KilowattSynthesis/Braille-Display-Column-Rods/README.md

# Braille-Display-Column-Rods
Braille display POC using tiny stepper motors to drive columns of the display

**Type 4 Braille Display**

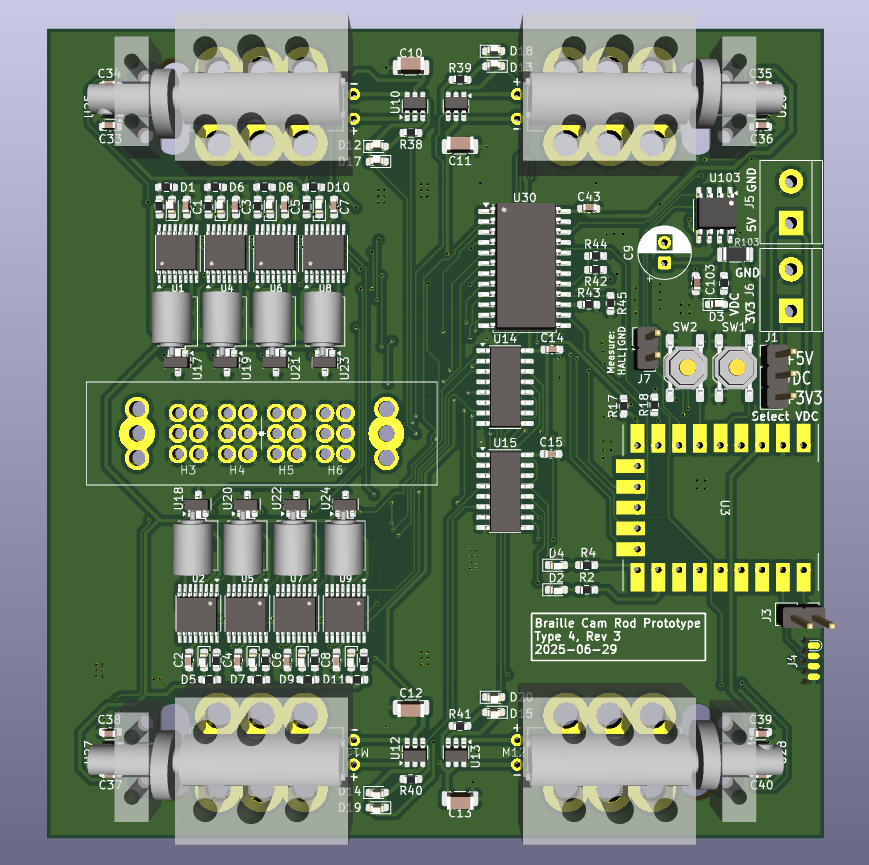
[picture p1: docs/renders/type-4-latest-top.png]
Type 4 Braille Display - Top Render
