KilowattSynthesis/Braille-Display-Column-Rods/docs/renders/type-4-rev-2-top.png

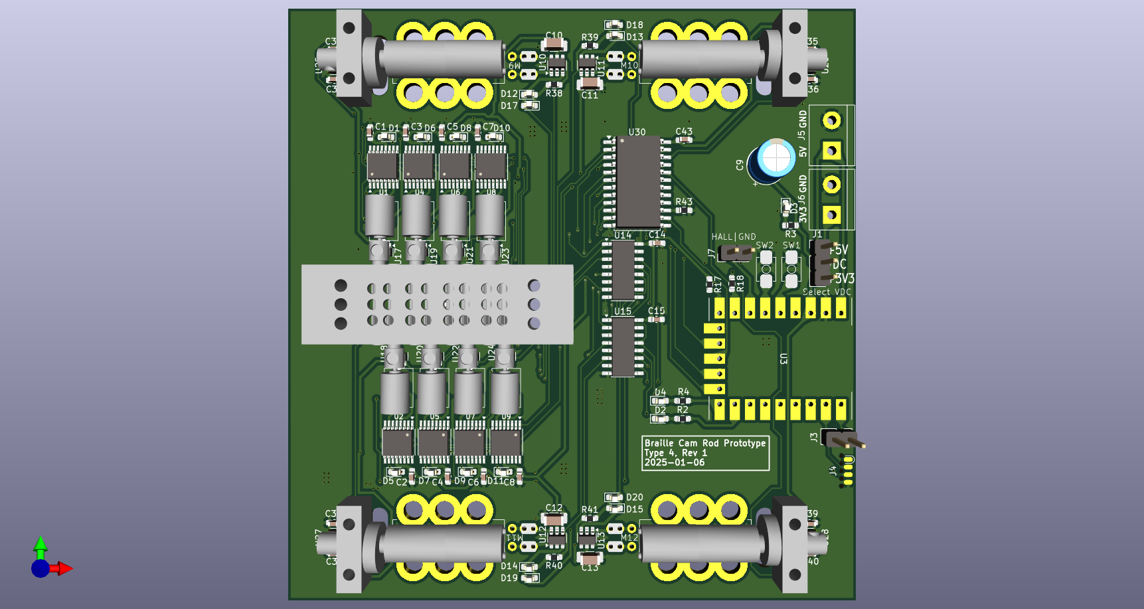
docs/renders/type-4-rev-2-top.png
