KilowattSynthesis/Braille-Display-Column-Rods/Braille-Column-Rods-PCB/lib-cad/octagon_cam_housing_assembly_preview_3p2_coupler.step

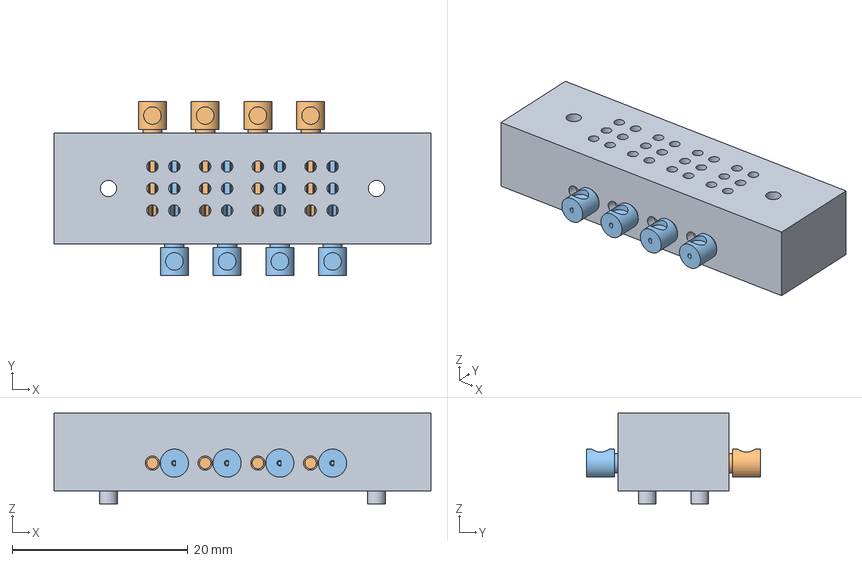
[picture p3: CAD file, 2025-03-13]
Braille-Column-Rods-PCB/lib-cad/octagon_cam_housing_assembly_preview_3p2_coupler.step
42.9 x 19.8 x 10.3 mm
