KilowattSynthesis/Braille-Display-Column-Rods/Braille-Column-Rods-PCB/lib-cad/assembly_cam_and_dc_motor.step

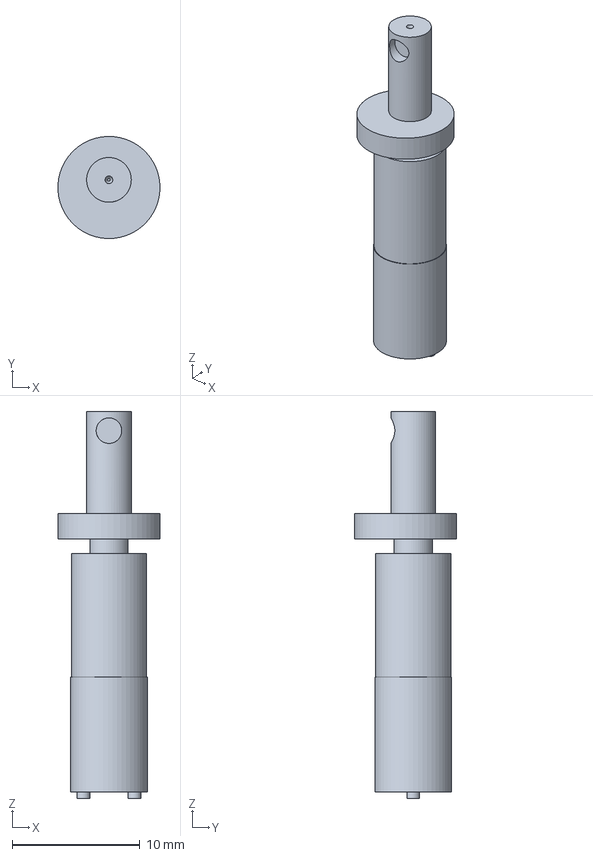
[picture p5: CAD file, 2025-02-03]
Braille-Column-Rods-PCB/lib-cad/assembly_cam_and_dc_motor.step
7.99 x 8.00 x 30.3 mm
