KilowattSynthesis/Braille-Display-Column-Rods/Braille-Column-Rods-PCB/lib-cad/bushing_block.step

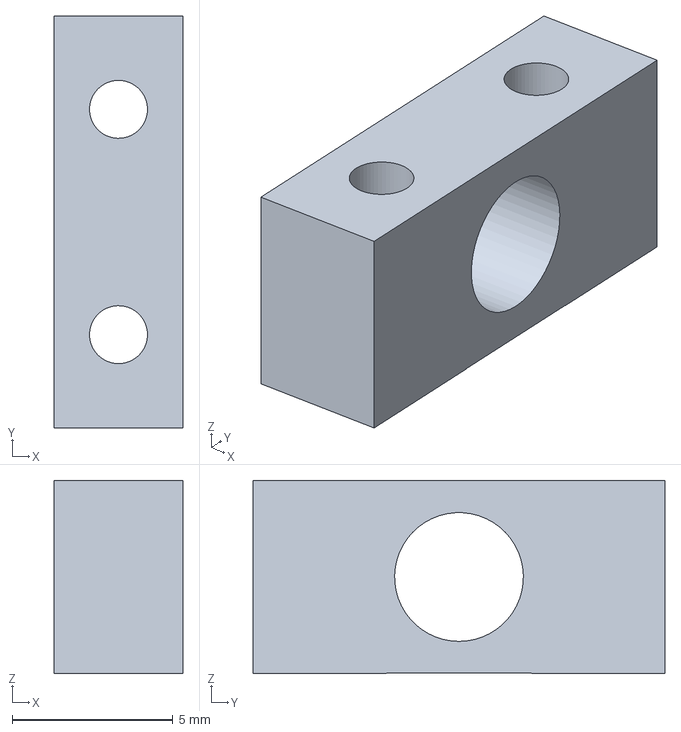
[picture p6: CAD file, 2025-03-13]
Braille-Column-Rods-PCB/lib-cad/bushing_block.step
4.00 x 12.8 x 6.00 mm
