KilowattSynthesis/Braille-Display-Column-Rods/Braille-Column-Rods-PCB/lib-cad/dc_motor_clamp.step

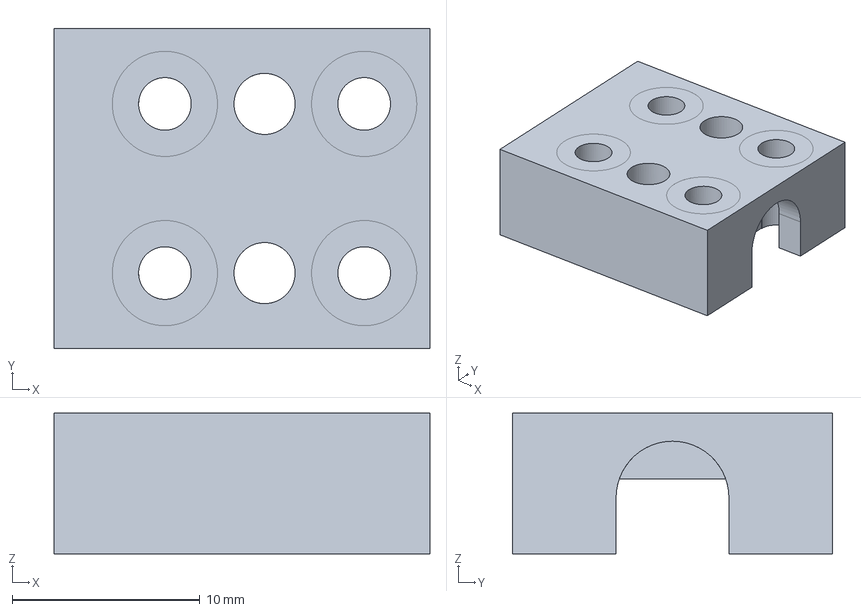
[picture p7: CAD file, 2025-03-13]
Braille-Column-Rods-PCB/lib-cad/dc_motor_clamp.step
20.0 x 17.0 x 7.50 mm
