KilowattSynthesis/Braille-Display-Column-Rods/Braille-Column-Rods-PCB/lib-cad/micro_stepper_motor_od_4p7.step

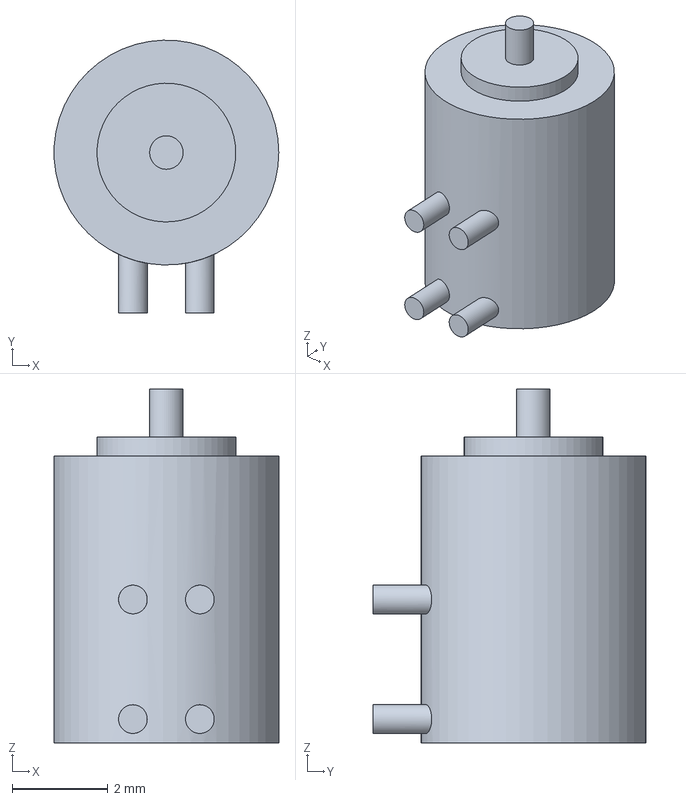
[picture p8: CAD file, 2025-02-03]
Braille-Column-Rods-PCB/lib-cad/micro_stepper_motor_od_4p7.step
4.70 x 5.70 x 7.40 mm
