KilowattSynthesis/Braille-Display-Column-Rods/Braille-Column-Rods-PCB/lib-cad/dc_motor_and_gearbox_6mm_3_stages.step

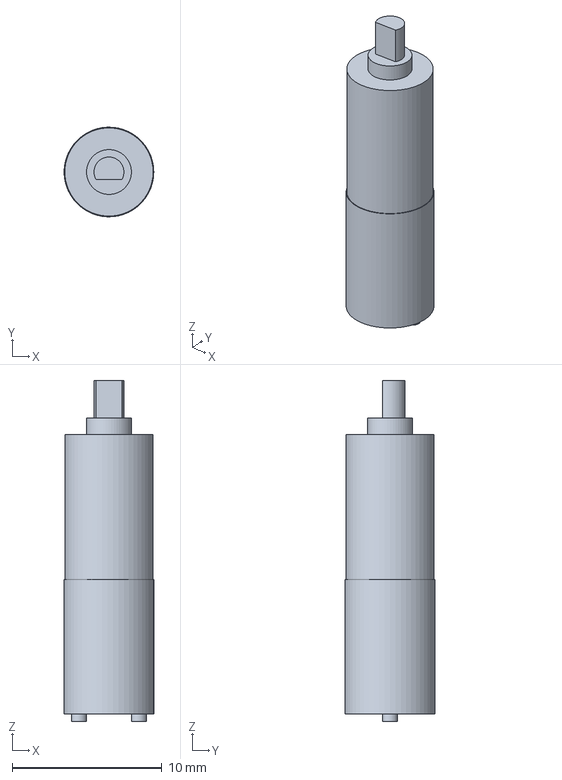
[picture p9: CAD file, 2025-02-03]
Braille-Column-Rods-PCB/lib-cad/dc_motor_and_gearbox_6mm_3_stages.step
5.99 x 6.00 x 22.8 mm
