KilowattSynthesis/Braille-Display-Column-Rods/Braille-Column-Rods-PCB/lib-cad/octagon_cam_housing_print_in_place.step

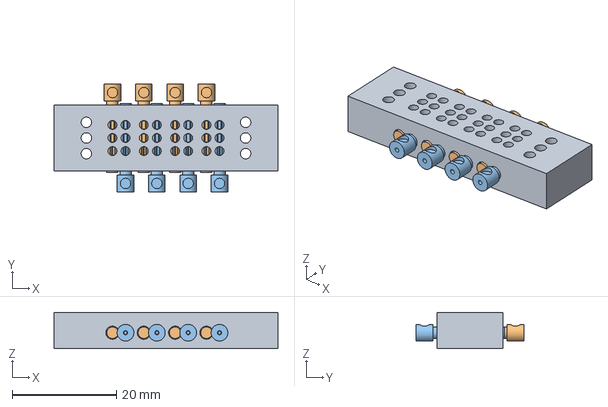
[picture p10: CAD file, 2025-02-03]
Braille-Column-Rods-PCB/lib-cad/octagon_cam_housing_print_in_place.step
42.9 x 20.6 x 6.95 mm
