KilowattSynthesis/Braille-Display-Column-Rods/Braille-Column-Rods-PCB/lib-cad/cam.step

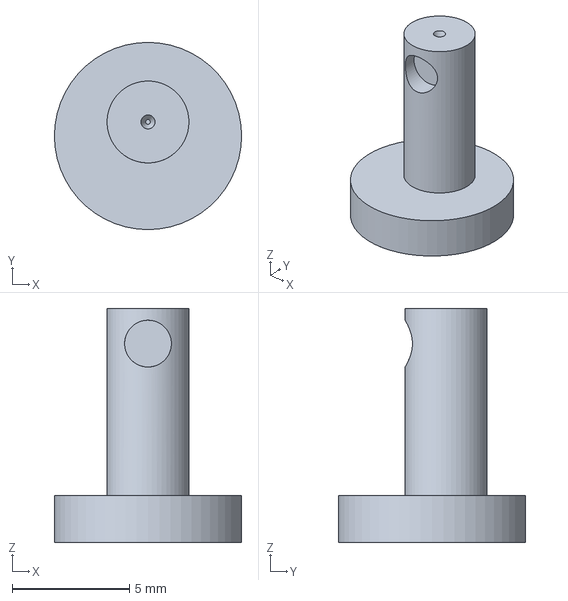
[picture p11: CAD file, 2025-02-03]
Braille-Column-Rods-PCB/lib-cad/cam.step
8.00 x 8.00 x 10.0 mm
