KilowattSynthesis/Braille-Display-Column-Rods/Braille-Column-Rods-PCB/Braille-Column-Rods-PCB.kicad_pcb

## KiCad design Braille-Column-Rods-PCB/Braille-Column-Rods-PCB.kicad_pcb (2025-06-30)

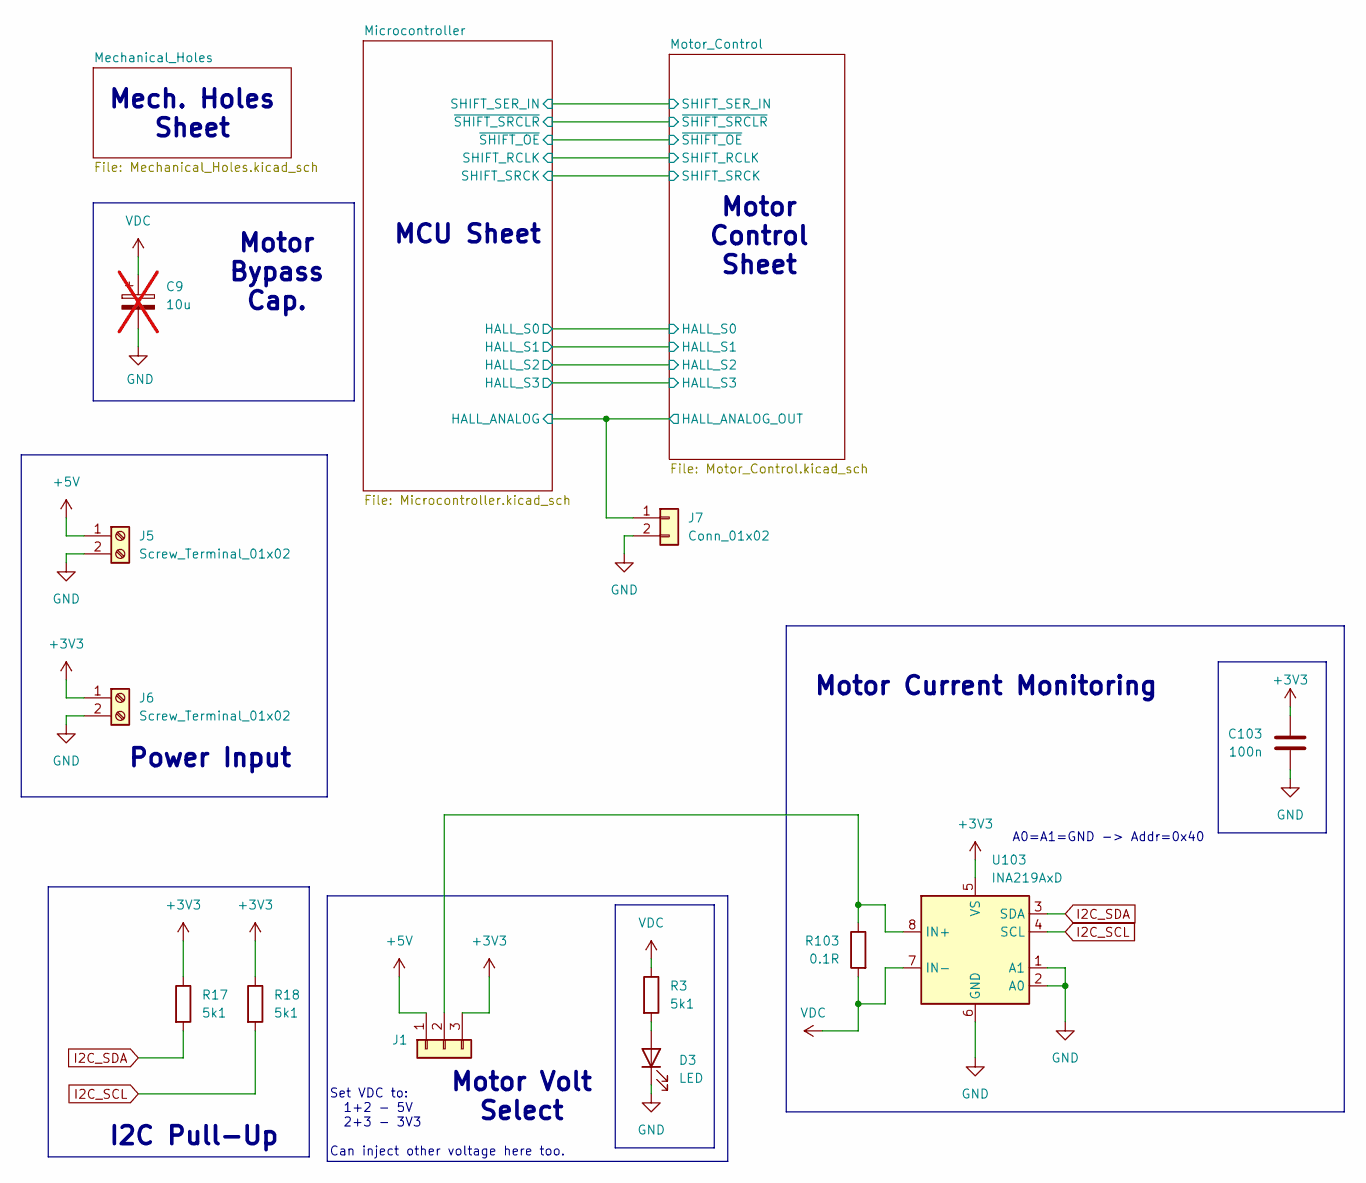
[picture p12: schematic Braille-Column-Rods-PCB.kicad_sch, Braille Cam Rod Prototype (Type 4)]

Parts:
C9: 10u; CP_Radial_D6.3mm_P2.50mm; not fitted
C103: 100n; C_0603_1608Metric_Pad1.08x0.95mm_HandSolder
D3: LED; LED_0603_1608Metric_Pad1.05x0.95mm_HandSolder
J1: Conn_01x03; PinHeader_1x03_P2.54mm_Vertical
J5, J6: Screw_Terminal_01x02; TerminalBlock_bornier-2_P5.08mm
J7: Conn_01x02; PinHeader_1x02_P2.54mm_Vertical
R3, R17, R18: 5k1; R_0603_1608Metric_Pad0.98x0.95mm_HandSolder
R103: 0.1R; R_1206_3216Metric_Pad1.30x1.75mm_HandSolder
U103: INA219AxD; SOIC-8_3.9x4.9mm_P1.27mm

Connections:
+3V3: C103.1, J1.3, J6.1, R17.1, R18.1, U103.5 (VS); also elsewhere on the board
+5V: J1.1, J5.1; also elsewhere on the board
/Microcontroller/HALL_ANALOG: J7.1; also elsewhere on the board
GND: C9.2, C103.2, D3.1 (K), J5.2, J6.2, J7.2, U103.1 (A1), U103.2 (A0), U103.6 (GND); also elsewhere on the board
I2C_SCL: R18.2, U103.4 (SCL); also elsewhere on the board
I2C_SDA: R17.2, U103.3 (SDA); also elsewhere on the board
unnamed: D3.2 (A), R3.2
unnamed: J1.2, R103.1, U103.8 (IN+)
VDC: C9.1, R3.1, R103.2, U103.7 (IN-); also elsewhere on the board

Notes on the sheet:
Motor Volt Select
Motor Bypass Cap.
A0=A1=GND -> Addr=0x40
Motor Current Monitoring
Mech. Holes Sheet
I2C Pull-Up
Set VDC to: 1+2 - 5V 2+3 - 3V3 Can inject other voltage here too.
MCU Sheet
Power Input
Motor Control Sheet

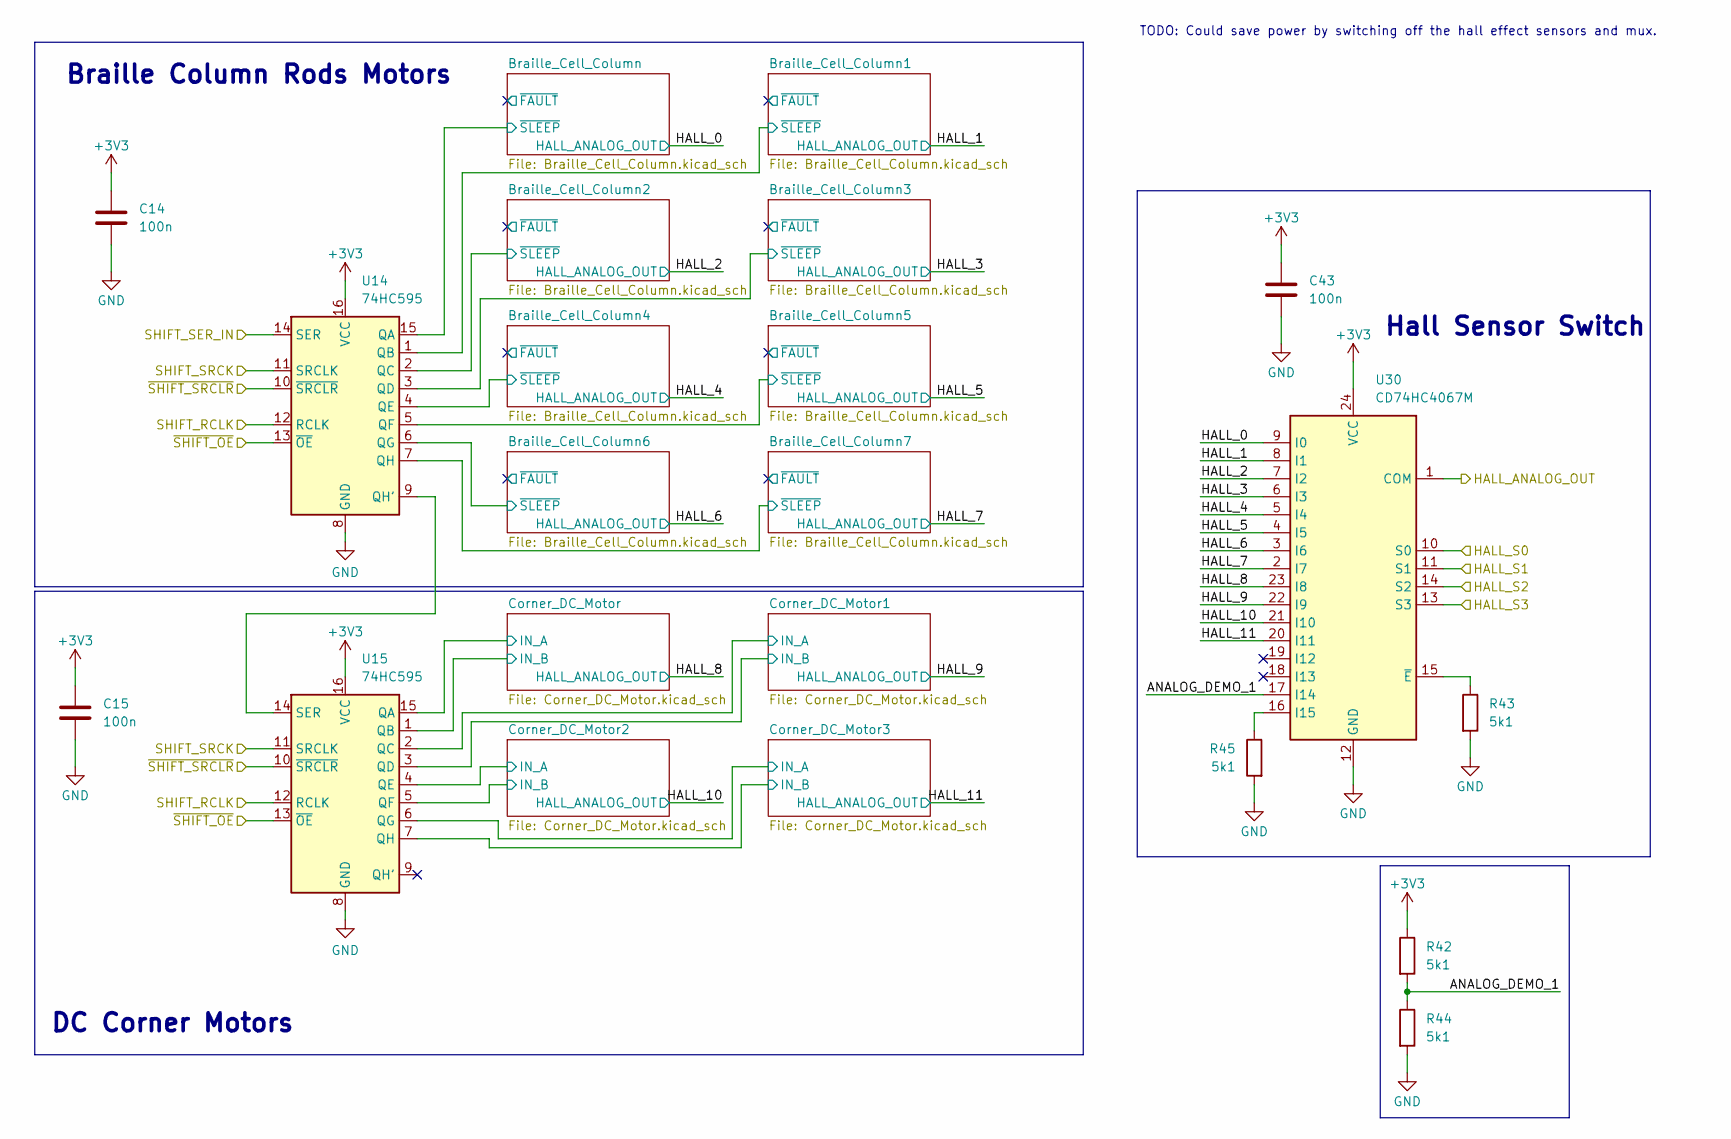
[picture p13: schematic Motor_Control.kicad_sch, Braille Cam Rod Prototype (Type 4)]

Parts:
C14, C15, C43: 100n; C_0603_1608Metric_Pad1.08x0.95mm_HandSolder
R42, R43, R44, R45: 5k1; R_0603_1608Metric_Pad0.98x0.95mm_HandSolder
U14, U15: 74HC595; SOP-16_3.9x9.9mm_P1.27mm; LCSC C5947
U30: CD74HC4067M; SOIC-24W_7.5x15.4mm_P1.27mm

Connections:
+3V3: C14.1, C15.1, C43.1, R42.1, U14.16 (VCC), U15.16 (VCC), U30.24 (VCC); also elsewhere on the board
/Microcontroller/HALL_ANALOG: U30.1 (COM); also elsewhere on the board
/Microcontroller/HALL_S0: U30.10 (S0); also elsewhere on the board
/Microcontroller/HALL_S1: U30.11 (S1); also elsewhere on the board
/Microcontroller/HALL_S2: U30.14 (S2); also elsewhere on the board
/Microcontroller/HALL_S3: U30.13 (S3); also elsewhere on the board
/Microcontroller/SHIFT_RCLK: U14.12 (RCLK), U15.12 (RCLK); also elsewhere on the board
/Microcontroller/SHIFT_SER_IN: U14.14 (SER); also elsewhere on the board
/Microcontroller/SHIFT_SRCK: U14.11 (SRCLK), U15.11 (SRCLK); also elsewhere on the board
/Microcontroller/~SHIFT_OE: U14.13 (~OE), U15.13 (~OE); also elsewhere on the board
/Microcontroller/~SHIFT_SRCLR: U14.10 (~SRCLR), U15.10 (~SRCLR); also elsewhere on the board
/Motor_Control/ANALOG_DEMO_1: R42.2, R44.1, U30.17 (I14)
/Motor_Control/Braille_Cell_Column1/~SLEEP: U14.1 (QB); also elsewhere on the board
/Motor_Control/Braille_Cell_Column2/~SLEEP: U14.2 (QC); also elsewhere on the board
/Motor_Control/Braille_Cell_Column3/~SLEEP: U14.3 (QD); also elsewhere on the board
/Motor_Control/Braille_Cell_Column4/~SLEEP: U14.4 (QE); also elsewhere on the board
/Motor_Control/Braille_Cell_Column5/~SLEEP: U14.5 (QF); also elsewhere on the board
/Motor_Control/Braille_Cell_Column6/~SLEEP: U14.6 (QG); also elsewhere on the board
/Motor_Control/Braille_Cell_Column7/~SLEEP: U14.7 (QH); also elsewhere on the board
/Motor_Control/Braille_Cell_Column/~SLEEP: U14.15 (QA); also elsewhere on the board
/Motor_Control/Corner_DC_Motor1/IN_A: U15.2 (QC); also elsewhere on the board
/Motor_Control/Corner_DC_Motor1/IN_B: U15.3 (QD); also elsewhere on the board
/Motor_Control/Corner_DC_Motor2/IN_A: U15.4 (QE); also elsewhere on the board
/Motor_Control/Corner_DC_Motor2/IN_B: U15.5 (QF); also elsewhere on the board
/Motor_Control/Corner_DC_Motor3/IN_A: U15.6 (QG); also elsewhere on the board
/Motor_Control/Corner_DC_Motor3/IN_B: U15.7 (QH); also elsewhere on the board
/Motor_Control/Corner_DC_Motor/IN_A: U15.15 (QA); also elsewhere on the board
/Motor_Control/Corner_DC_Motor/IN_B: U15.1 (QB); also elsewhere on the board
/Motor_Control/HALL_0: U30.9 (I0); also elsewhere on the board
/Motor_Control/HALL_1: U30.8 (I1); also elsewhere on the board
/Motor_Control/HALL_2: U30.7 (I2); also elsewhere on the board
/Motor_Control/HALL_3: U30.6 (I3); also elsewhere on the board
/Motor_Control/HALL_4: U30.5 (I4); also elsewhere on the board
/Motor_Control/HALL_5: U30.4 (I5); also elsewhere on the board
/Motor_Control/HALL_6: U30.3 (I6); also elsewhere on the board
/Motor_Control/HALL_7: U30.2 (I7); also elsewhere on the board
/Motor_Control/HALL_8: U30.23 (I8); also elsewhere on the board
/Motor_Control/HALL_9: U30.22 (I9); also elsewhere on the board
/Motor_Control/HALL_10: U30.21 (I10); also elsewhere on the board
/Motor_Control/HALL_11: U30.20 (I11); also elsewhere on the board
GND: C14.2, C15.2, C43.2, R43.2, R44.2, R45.2, U14.8 (GND), U15.8 (GND), U30.12 (GND); also elsewhere on the board
unnamed: U14.9 (QH'), U15.14 (SER)
unnamed: R45.1, U30.16 (I15)
unnamed: R43.1, U30.15 (~E)

Notes on the sheet:
Hall Sensor Switch
Braille Column Rods Motors
TODO: Could save power by switching off the hall effect sensors and mux.
DC Corner Motors

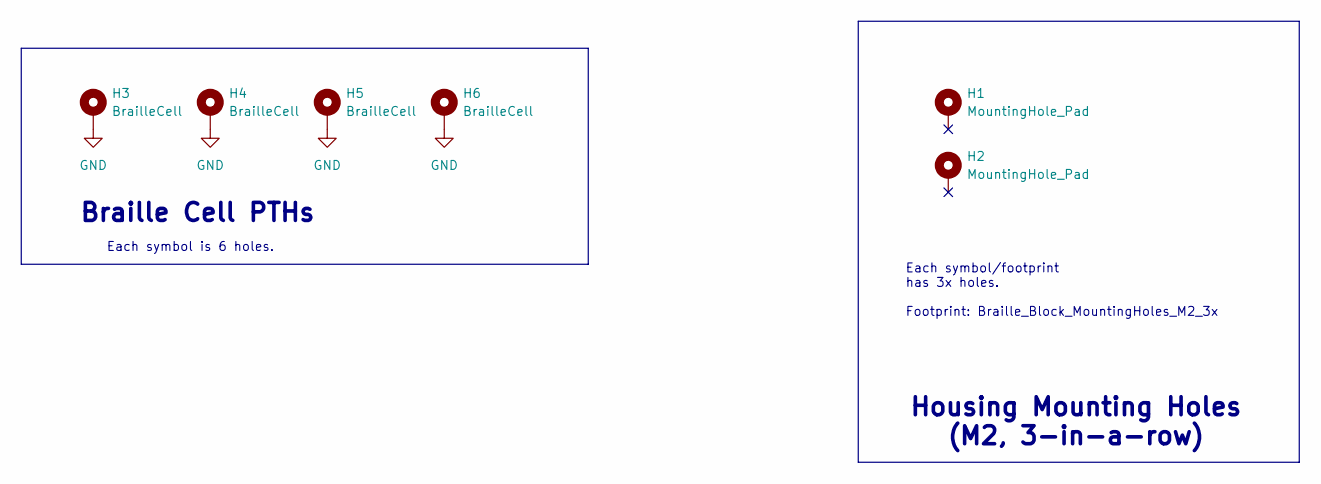
[picture p14: schematic Mechanical_Holes.kicad_sch, Braille Cam Rod Prototype (Type 4)]

Parts:
H1, H2: MountingHole_Pad; Braille_Block_MountingHoles_M2_3x
H3, H4, H5, H6: BrailleCell

Connections:
GND: H3.1, H4.1, H5.1, H6.1; also elsewhere on the board

Notes on the sheet:
Each symbol/footprint has 3x holes. Footprint: Braille_Block_MountingHoles_M2_3x
Housing Mounting Holes (M2, 3-in-a-row)
Braille Cell PTHs
Each symbol is 6 holes.

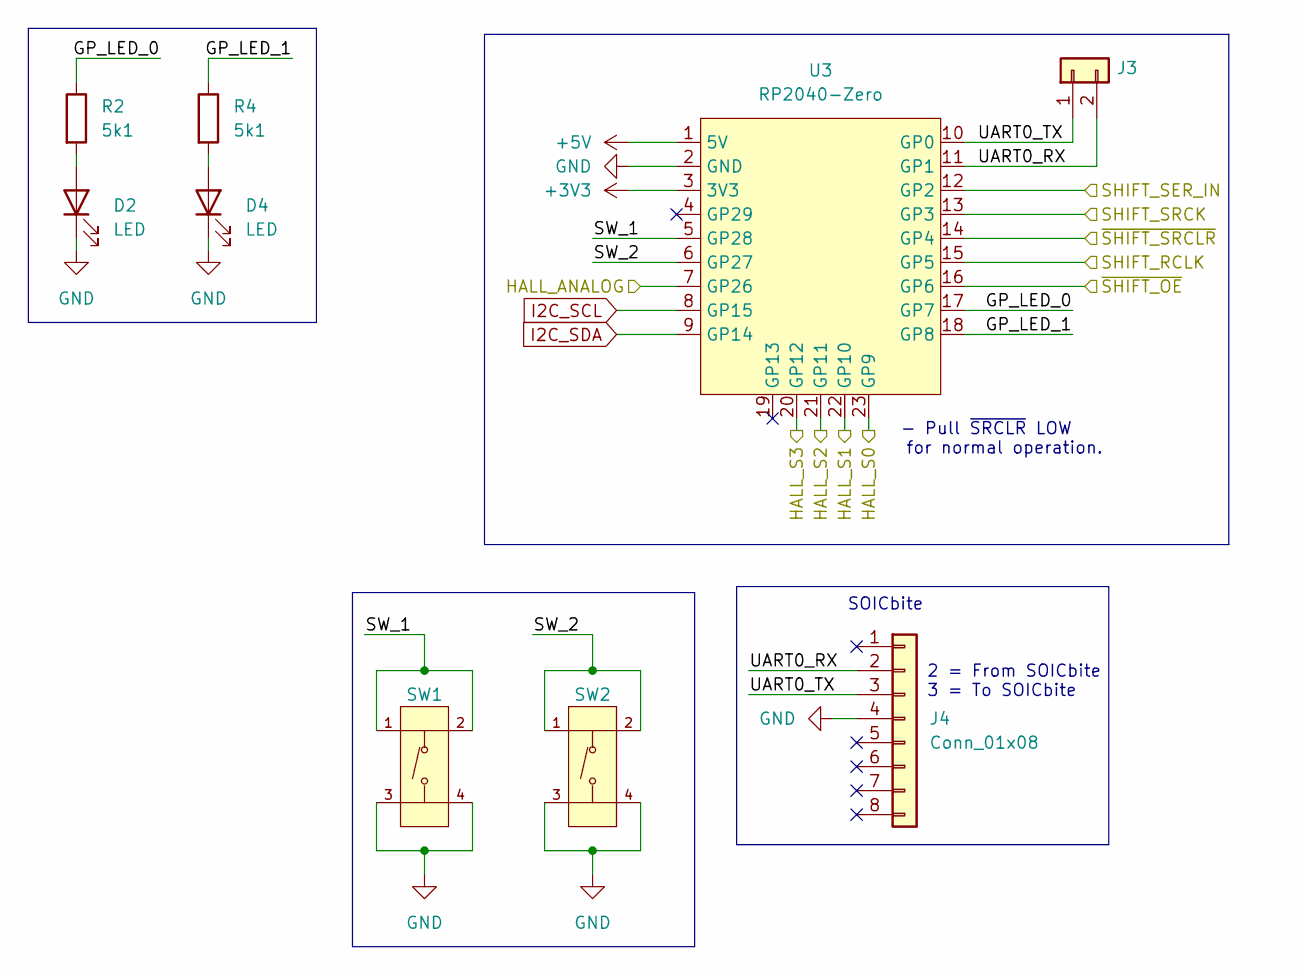
[picture p15: schematic Microcontroller.kicad_sch, Braille Cam Rod Prototype (Type 4)]

Parts:
D2, D4: LED; LED_0603_1608Metric_Pad1.05x0.95mm_HandSolder
J3: Conn_01x02; PinHeader_1x02_P2.54mm_Vertical
J4: Conn_01x08; SOICbite_clipProgSmall
R2, R4: 5k1; R_0603_1608Metric_Pad0.98x0.95mm_HandSolder
SW1, SW2: Tactile Button, 160gf; SW-SMD_4P-L5.1-W5.1-P3.70-LS6.5-TL-2; Voltage Rating (Dc) 12V; Part TS-1187A-B-A-B; LCSC C318884
U3: RP2040-Zero; RP2040 Zero

Connections:
+3V3: U3.3 (3V3); also elsewhere on the board
+5V: U3.1 (5V); also elsewhere on the board
/Microcontroller/GP_LED_0: R2.1, U3.17 (GP7)
/Microcontroller/GP_LED_1: R4.1, U3.18 (GP8)
/Microcontroller/HALL_ANALOG: U3.7 (GP26); also elsewhere on the board
/Microcontroller/HALL_S0: U3.23 (GP9); also elsewhere on the board
/Microcontroller/HALL_S1: U3.22 (GP10); also elsewhere on the board
/Microcontroller/HALL_S2: U3.21 (GP11); also elsewhere on the board
/Microcontroller/HALL_S3: U3.20 (GP12); also elsewhere on the board
/Microcontroller/SHIFT_RCLK: U3.15 (GP5); also elsewhere on the board
/Microcontroller/SHIFT_SER_IN: U3.12 (GP2); also elsewhere on the board
/Microcontroller/SHIFT_SRCK: U3.13 (GP3); also elsewhere on the board
/Microcontroller/SW_1: SW1.1 (A), SW1.2 (B), U3.5 (GP28)
/Microcontroller/SW_2: SW2.1 (A), SW2.2 (B), U3.6 (GP27)
/Microcontroller/UART0_RX: J3.2, J4.2, U3.11 (GP1)
/Microcontroller/UART0_TX: J3.1, J4.3, U3.10 (GP0)
/Microcontroller/~SHIFT_OE: U3.16 (GP6); also elsewhere on the board
/Microcontroller/~SHIFT_SRCLR: U3.14 (GP4); also elsewhere on the board
GND: D2.1 (K), D4.1 (K), J4.4, SW1.3 (C), SW1.4 (D), SW2.3 (C), SW2.4 (D), U3.2 (GND); also elsewhere on the board
I2C_SCL: U3.8 (GP15); also elsewhere on the board
I2C_SDA: U3.9 (GP14); also elsewhere on the board
unnamed: D2.2 (A), R2.2
unnamed: D4.2 (A), R4.2

Notes on the sheet:
SOICbite
2 = From SOICbite 3 = To SOICbite
- Pull ~{SRCLR} LOW for normal operation.

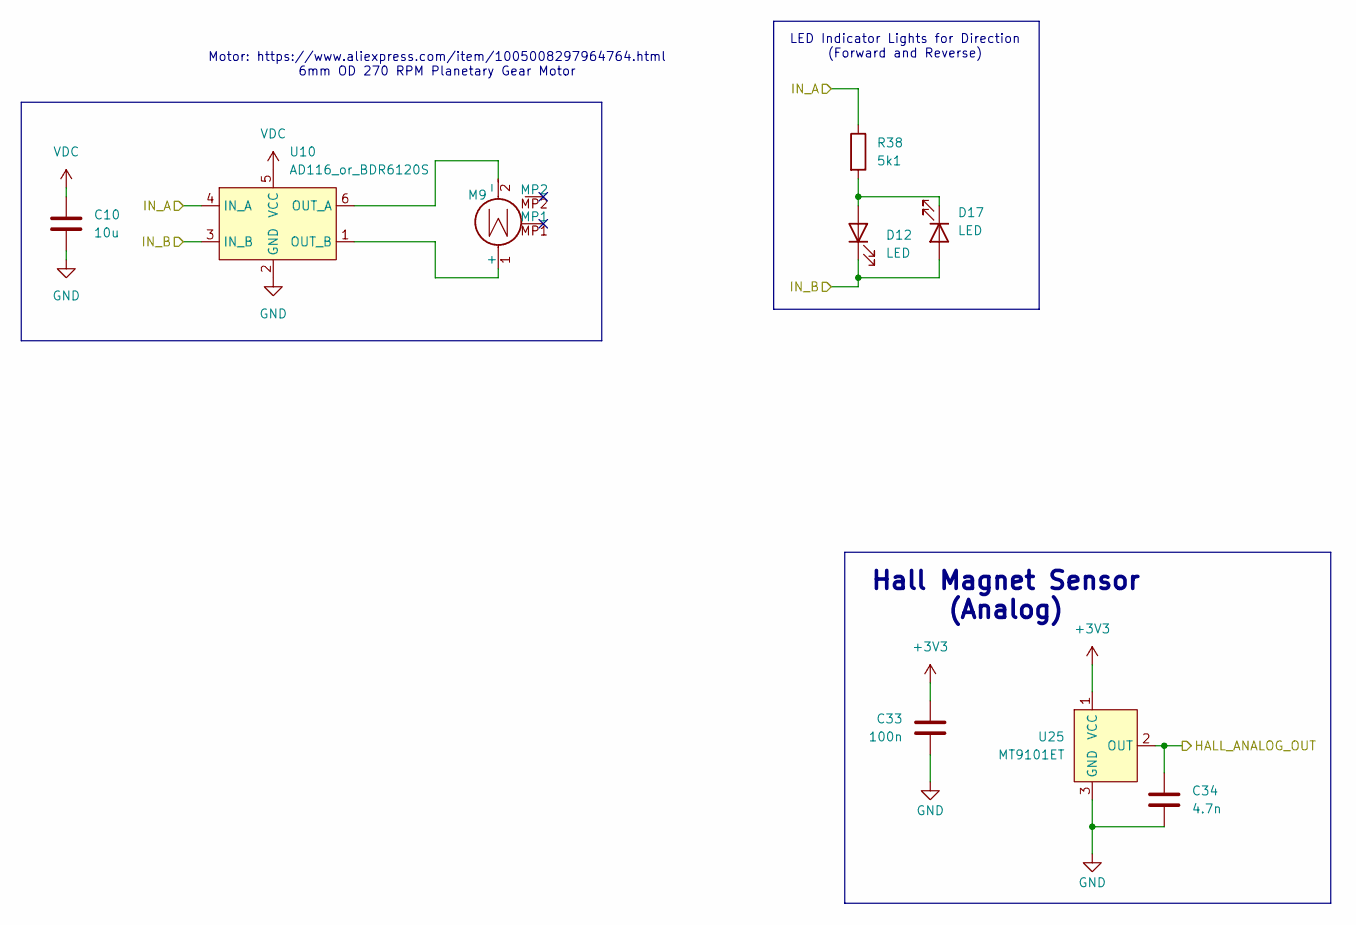
[picture p16: schematic Corner_DC_Motor.kicad_sch, Braille Cam Rod Prototype (Type 4)]

Parts:
C10: 10u; C_1206_3216Metric_Pad1.33x1.80mm_HandSolder
C33: 100n; C_0603_1608Metric_Pad1.08x0.95mm_HandSolder
C34: 4.7n; C_0603_1608Metric_Pad1.08x0.95mm_HandSolder
D12, D17: LED; LED_0603_1608Metric_Pad1.05x0.95mm_HandSolder
M9: Motor_DC_With_MP; DC_Motor_6mm_OD_with_3_Stage_Gearbox
R38: 5k1; R_0603_1608Metric_Pad0.98x0.95mm_HandSolder
U10: AD116_or_BDR6120S; SOT-23-6; LCSC C5455570
U25: MT9101ET; SOT-23-Hall; LCSC C2977713

Connections:
+3V3: C33.1, U25.1 (VCC); also elsewhere on the board
/Motor_Control/Corner_DC_Motor/IN_A: R38.1, U10.4 (IN_A); also elsewhere on the board
/Motor_Control/Corner_DC_Motor/IN_B: D12.1 (K), D17.2 (A), U10.3 (IN_B); also elsewhere on the board
/Motor_Control/HALL_8: C34.1, U25.2 (OUT); also elsewhere on the board
GND: C10.2, C33.2, C34.2, U10.2 (GND), U25.3 (GND); also elsewhere on the board
unnamed: D12.2 (A), D17.1 (K), R38.2
unnamed: M9.1 (+), U10.1 (OUT_B)
unnamed: M9.2 (-), U10.6 (OUT_A)
VDC: C10.1, U10.5 (VCC); also elsewhere on the board

Parts of its further copies:
C11, C12, C13: 10u; C_1206_3216Metric_Pad1.33x1.80mm_HandSolder
C35, C37, C39: 100n; C_0603_1608Metric_Pad1.08x0.95mm_HandSolder
C36, C38, C40: 4.7n; C_0603_1608Metric_Pad1.08x0.95mm_HandSolder
D13, D14, D15, D18, D19, D20: LED; LED_0603_1608Metric_Pad1.05x0.95mm_HandSolder
M10, M11, M12: Motor_DC_With_MP; DC_Motor_6mm_OD_with_3_Stage_Gearbox
R39, R40, R41: 5k1; R_0603_1608Metric_Pad0.98x0.95mm_HandSolder
U11, U12, U13: AD116_or_BDR6120S; SOT-23-6; LCSC C5455570
U26, U27, U28: MT9101ET; SOT-23-Hall; LCSC C2977713

Connections of its further copies:
+3V3: C35.1, C37.1, C39.1, U26.1 (VCC), U27.1 (VCC), U28.1 (VCC); also elsewhere on the board
/Motor_Control/Corner_DC_Motor1/IN_A: R39.1, U11.4 (IN_A); also elsewhere on the board
/Motor_Control/Corner_DC_Motor1/IN_B: D13.1 (K), D18.2 (A), U11.3 (IN_B); also elsewhere on the board
/Motor_Control/Corner_DC_Motor2/IN_A: R40.1, U12.4 (IN_A); also elsewhere on the board
/Motor_Control/Corner_DC_Motor2/IN_B: D14.1 (K), D19.2 (A), U12.3 (IN_B); also elsewhere on the board
/Motor_Control/Corner_DC_Motor3/IN_A: R41.1, U13.4 (IN_A); also elsewhere on the board
/Motor_Control/Corner_DC_Motor3/IN_B: D15.1 (K), D20.2 (A), U13.3 (IN_B); also elsewhere on the board
/Motor_Control/HALL_9: C36.1, U26.2 (OUT); also elsewhere on the board
/Motor_Control/HALL_10: C38.1, U27.2 (OUT); also elsewhere on the board
/Motor_Control/HALL_11: C40.1, U28.2 (OUT); also elsewhere on the board
GND: C11.2, C12.2, C13.2, C35.2, C36.2, C37.2, C38.2, C39.2, C40.2, U11.2 (GND), U12.2 (GND), U13.2 (GND), U26.3 (GND), U27.3 (GND), U28.3 (GND); also elsewhere on the board
unnamed: D13.2 (A), D18.1 (K), R39.2
unnamed: D14.2 (A), D19.1 (K), R40.2
unnamed: D15.2 (A), D20.1 (K), R41.2
unnamed: M10.1 (+), U11.1 (OUT_B)
unnamed: M10.2 (-), U11.6 (OUT_A)
unnamed: M11.1 (+), U12.1 (OUT_B)
unnamed: M11.2 (-), U12.6 (OUT_A)
unnamed: M12.1 (+), U13.1 (OUT_B)
unnamed: M12.2 (-), U13.6 (OUT_A)
VDC: C11.1, C12.1, C13.1, U11.5 (VCC), U12.5 (VCC), U13.5 (VCC); also elsewhere on the board

Notes on the sheet:
LED Indicator Lights for Direction (Forward and Reverse)
Hall Magnet Sensor (Analog)
Motor: https://www.aliexpress.com/item/1005008297964764.html 6mm OD 270 RPM Planetary Gear Motor

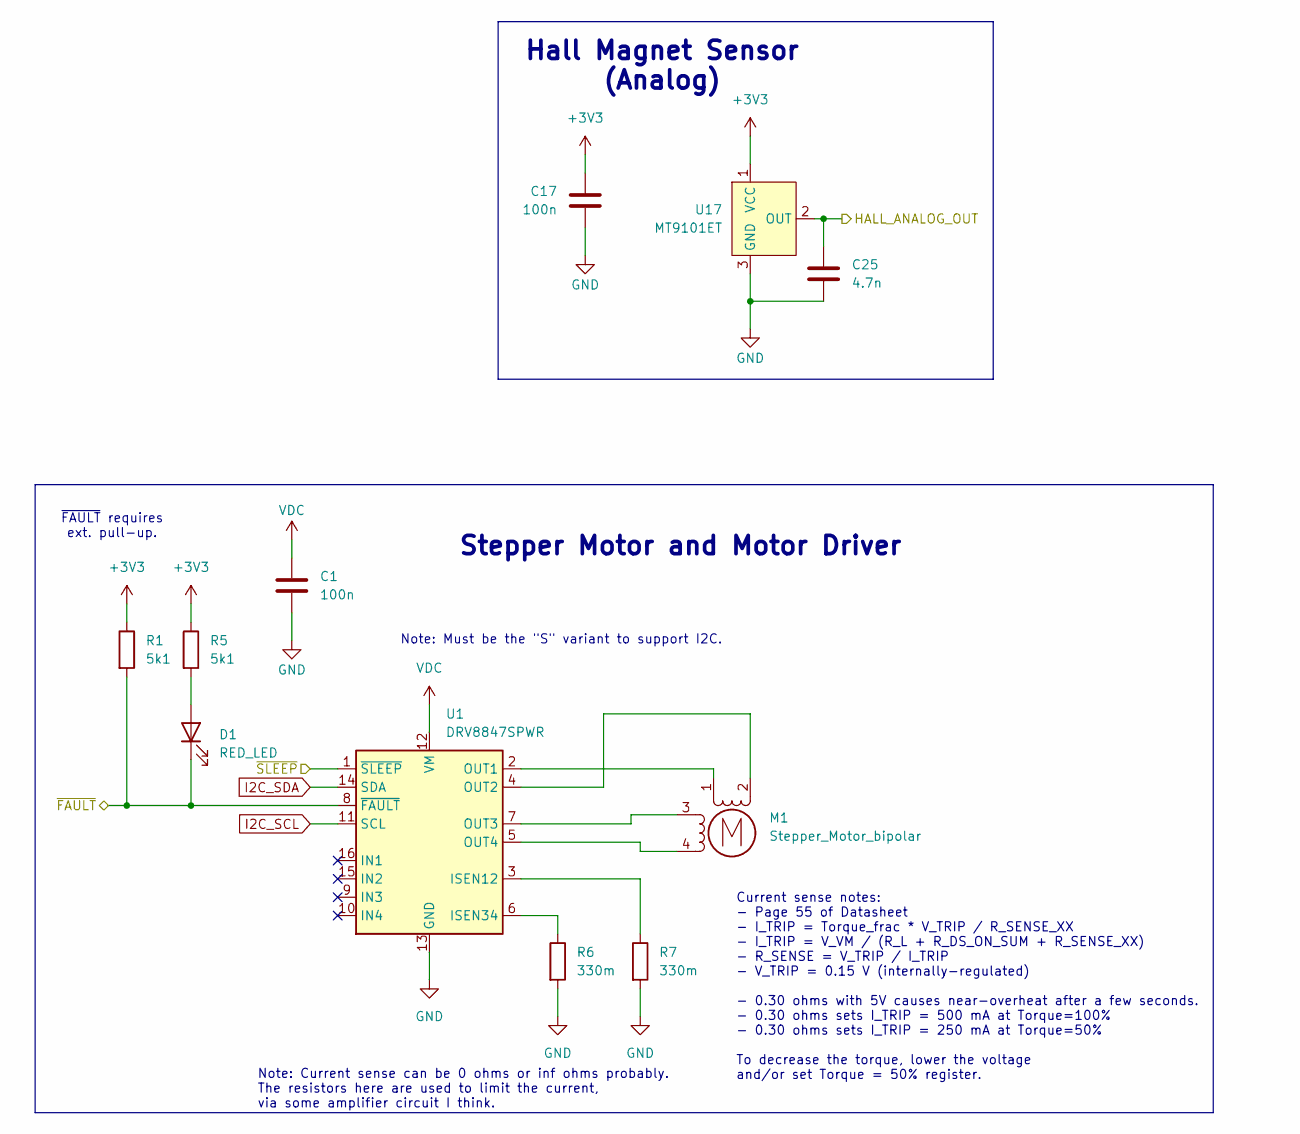
[picture p17: schematic Braille_Cell_Column.kicad_sch, Braille Cam Rod Prototype (Type 4)]

Parts:
C1, C17: 100n; C_0603_1608Metric_Pad1.08x0.95mm_HandSolder
C25: 4.7n; C_0603_1608Metric_Pad1.08x0.95mm_HandSolder
D1: RED_LED; LED_0603_1608Metric_Pad1.05x0.95mm_HandSolder
M1: Stepper_Motor_bipolar; MicroStepper_4.7_OD
R1, R5: 5k1; R_0603_1608Metric_Pad0.98x0.95mm_HandSolder
R6, R7: 330m; R_0603_1608Metric_Pad0.98x0.95mm_HandSolder
U1: DRV8847SPWR; TSSOP-16_4.4x5mm_P0.65mm
U17: MT9101ET; SOT-23-Hall; LCSC C2977713

Connections:
+3V3: C17.1, R1.1, R5.1, U17.1 (VCC); also elsewhere on the board
/Motor_Control/Braille_Cell_Column/~FAULT: D1.1 (K), R1.2, U1.8 (~FAULT)
/Motor_Control/Braille_Cell_Column/~SLEEP: U1.1 (~SLEEP); also elsewhere on the board
/Motor_Control/HALL_0: C25.1, U17.2 (OUT); also elsewhere on the board
GND: C1.2, C17.2, C25.2, R6.2, R7.2, U1.13 (GND), U17.3 (GND); also elsewhere on the board
I2C_SCL: U1.11 (SCL); also elsewhere on the board
I2C_SDA: U1.14 (SDA); also elsewhere on the board
unnamed: D1.2 (A), R5.2
unnamed: M1.2 (-), U1.4 (OUT2)
unnamed: R7.1, U1.3 (ISEN12)
unnamed: R6.1, U1.6 (ISEN34)
unnamed: M1.1, U1.2 (OUT1)
unnamed: M1.3, U1.7 (OUT3)
unnamed: M1.4, U1.5 (OUT4)
VDC: C1.1, U1.12 (VM); also elsewhere on the board

Parts of its further copies:
C2, C3, C4, C5, C6, C7, C8, C18, C19, C20, C21, C22, C23, C24: 100n; C_0603_1608Metric_Pad1.08x0.95mm_HandSolder
C26, C27, C28, C29, C30, C31, C32: 4.7n; C_0603_1608Metric_Pad1.08x0.95mm_HandSolder
D5, D6, D7, D8, D9, D10, D11: RED_LED; LED_0603_1608Metric_Pad1.05x0.95mm_HandSolder
M2, M3, M4, M5, M6, M7, M8: Stepper_Motor_bipolar; MicroStepper_4.7_OD
R8, R9, R12, R13, R16, R19, R22, R23, R26, R27, R30, R31, R34, R35: 5k1; R_0603_1608Metric_Pad0.98x0.95mm_HandSolder
R10, R11, R14, R15, R20, R21, R24, R25, R28, R29, R32, R33, R36, R37: 330m; R_0603_1608Metric_Pad0.98x0.95mm_HandSolder
U2, U4, U5, U6, U7, U8, U9: DRV8847SPWR; TSSOP-16_4.4x5mm_P0.65mm
U18, U19, U20, U21, U22, U23, U24: MT9101ET; SOT-23-Hall; LCSC C2977713

Connections of its further copies:
+3V3: C18.1, C19.1, C20.1, C21.1, C22.1, C23.1, C24.1, R8.1, R9.1, R12.1, R13.1, R16.1, R19.1, R22.1, R23.1, R26.1, R27.1, R30.1, R31.1, R34.1, R35.1, U18.1 (VCC), U19.1 (VCC), U20.1 (VCC), U21.1 (VCC), U22.1 (VCC), U23.1 (VCC), U24.1 (VCC); also elsewhere on the board
/Motor_Control/Braille_Cell_Column1/~FAULT: D5.1 (K), R8.2, U2.8 (~FAULT)
/Motor_Control/Braille_Cell_Column1/~SLEEP: U2.1 (~SLEEP); also elsewhere on the board
/Motor_Control/Braille_Cell_Column2/~FAULT: D6.1 (K), R12.2, U4.8 (~FAULT)
/Motor_Control/Braille_Cell_Column2/~SLEEP: U4.1 (~SLEEP); also elsewhere on the board
/Motor_Control/Braille_Cell_Column3/~FAULT: D7.1 (K), R16.2, U5.8 (~FAULT)
/Motor_Control/Braille_Cell_Column3/~SLEEP: U5.1 (~SLEEP); also elsewhere on the board
/Motor_Control/Braille_Cell_Column4/~FAULT: D8.1 (K), R22.2, U6.8 (~FAULT)
/Motor_Control/Braille_Cell_Column4/~SLEEP: U6.1 (~SLEEP); also elsewhere on the board
/Motor_Control/Braille_Cell_Column5/~FAULT: D9.1 (K), R26.2, U7.8 (~FAULT)
/Motor_Control/Braille_Cell_Column5/~SLEEP: U7.1 (~SLEEP); also elsewhere on the board
/Motor_Control/Braille_Cell_Column6/~FAULT: D10.1 (K), R30.2, U8.8 (~FAULT)
/Motor_Control/Braille_Cell_Column6/~SLEEP: U8.1 (~SLEEP); also elsewhere on the board
/Motor_Control/Braille_Cell_Column7/~FAULT: D11.1 (K), R34.2, U9.8 (~FAULT)
/Motor_Control/Braille_Cell_Column7/~SLEEP: U9.1 (~SLEEP); also elsewhere on the board
/Motor_Control/HALL_1: C26.1, U18.2 (OUT); also elsewhere on the board
/Motor_Control/HALL_2: C27.1, U19.2 (OUT); also elsewhere on the board
/Motor_Control/HALL_3: C28.1, U20.2 (OUT); also elsewhere on the board
/Motor_Control/HALL_4: C29.1, U21.2 (OUT); also elsewhere on the board
/Motor_Control/HALL_5: C30.1, U22.2 (OUT); also elsewhere on the board
/Motor_Control/HALL_6: C31.1, U23.2 (OUT); also elsewhere on the board
/Motor_Control/HALL_7: C32.1, U24.2 (OUT); also elsewhere on the board
GND: C2.2, C3.2, C4.2, C5.2, C6.2, C7.2, C8.2, C18.2, C19.2, C20.2, C21.2, C22.2, C23.2, C24.2, C26.2, C27.2, C28.2, C29.2, C30.2, C31.2, C32.2, R10.2, R11.2, R14.2, R15.2, R20.2, R21.2, R24.2, R25.2, R28.2, R29.2, R32.2, R33.2, R36.2, R37.2, U2.13 (GND), U4.13 (GND), U5.13 (GND), U6.13 (GND), U7.13 (GND), U8.13 (GND), U9.13 (GND), U18.3 (GND), U19.3 (GND), U20.3 (GND), U21.3 (GND), U22.3 (GND), U23.3 (GND), U24.3 (GND); also elsewhere on the board
I2C_SCL: U2.11 (SCL), U4.11 (SCL), U5.11 (SCL), U6.11 (SCL), U7.11 (SCL), U8.11 (SCL), U9.11 (SCL); also elsewhere on the board
I2C_SDA: U2.14 (SDA), U4.14 (SDA), U5.14 (SDA), U6.14 (SDA), U7.14 (SDA), U8.14 (SDA), U9.14 (SDA); also elsewhere on the board
unnamed: D5.2 (A), R9.2
unnamed: D6.2 (A), R13.2
unnamed: D7.2 (A), R19.2
unnamed: D8.2 (A), R23.2
unnamed: D9.2 (A), R27.2
unnamed: D10.2 (A), R31.2
unnamed: D11.2 (A), R35.2
unnamed: M2.2 (-), U2.4 (OUT2)
unnamed: M3.2 (-), U4.4 (OUT2)
unnamed: M4.2 (-), U5.4 (OUT2)
unnamed: M5.2 (-), U6.4 (OUT2)
unnamed: M6.2 (-), U7.4 (OUT2)
unnamed: M7.2 (-), U8.4 (OUT2)
unnamed: M8.2 (-), U9.4 (OUT2)
unnamed: R11.1, U2.3 (ISEN12)
unnamed: R10.1, U2.6 (ISEN34)
unnamed: M2.1, U2.2 (OUT1)
unnamed: M2.3, U2.7 (OUT3)
unnamed: M2.4, U2.5 (OUT4)
unnamed: R15.1, U4.3 (ISEN12)
unnamed: R14.1, U4.6 (ISEN34)
unnamed: M3.1, U4.2 (OUT1)
unnamed: M3.3, U4.7 (OUT3)
unnamed: M3.4, U4.5 (OUT4)
unnamed: R21.1, U5.3 (ISEN12)
unnamed: R20.1, U5.6 (ISEN34)
unnamed: M4.1, U5.2 (OUT1)
unnamed: M4.3, U5.7 (OUT3)
unnamed: M4.4, U5.5 (OUT4)
unnamed: R25.1, U6.3 (ISEN12)
unnamed: R24.1, U6.6 (ISEN34)
unnamed: M5.1, U6.2 (OUT1)
unnamed: M5.3, U6.7 (OUT3)
unnamed: M5.4, U6.5 (OUT4)
unnamed: R29.1, U7.3 (ISEN12)
unnamed: R28.1, U7.6 (ISEN34)
unnamed: M6.1, U7.2 (OUT1)
unnamed: M6.3, U7.7 (OUT3)
unnamed: M6.4, U7.5 (OUT4)
unnamed: R33.1, U8.3 (ISEN12)
unnamed: R32.1, U8.6 (ISEN34)
unnamed: M7.1, U8.2 (OUT1)
unnamed: M7.3, U8.7 (OUT3)
unnamed: M7.4, U8.5 (OUT4)
unnamed: R37.1, U9.3 (ISEN12)
unnamed: R36.1, U9.6 (ISEN34)
unnamed: M8.1, U9.2 (OUT1)
unnamed: M8.3, U9.7 (OUT3)
unnamed: M8.4, U9.5 (OUT4)
VDC: C2.1, C3.1, C4.1, C5.1, C6.1, C7.1, C8.1, U2.12 (VM), U4.12 (VM), U5.12 (VM), U6.12 (VM), U7.12 (VM), U8.12 (VM), U9.12 (VM); also elsewhere on the board

Notes on the sheet:
Note: Current sense can be 0 ohms or inf ohms probably. The resistors here are used to limit the current, via some amplifier circuit I think.
Current sense notes: - Page 55 of Datasheet - I_TRIP = Torque_frac * V_TRIP / R_SENSE_XX - I_TRIP = V_VM / (R_L + R_DS_ON_SUM + R_SENSE_XX) - R_SENSE = V_TRIP / I_TRIP - V_TRIP = 0.15 V (internally-regulated) - 0.30 ohms with 5V causes near-overheat after a few seconds. - 0.30 ohms sets I_TRIP = 50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
~{FAULT} requires ext. pull-up.
Note: Must be the "S" variant to support I2C.
Stepper Motor and Motor Driver
Hall Magnet Sensor (Analog)

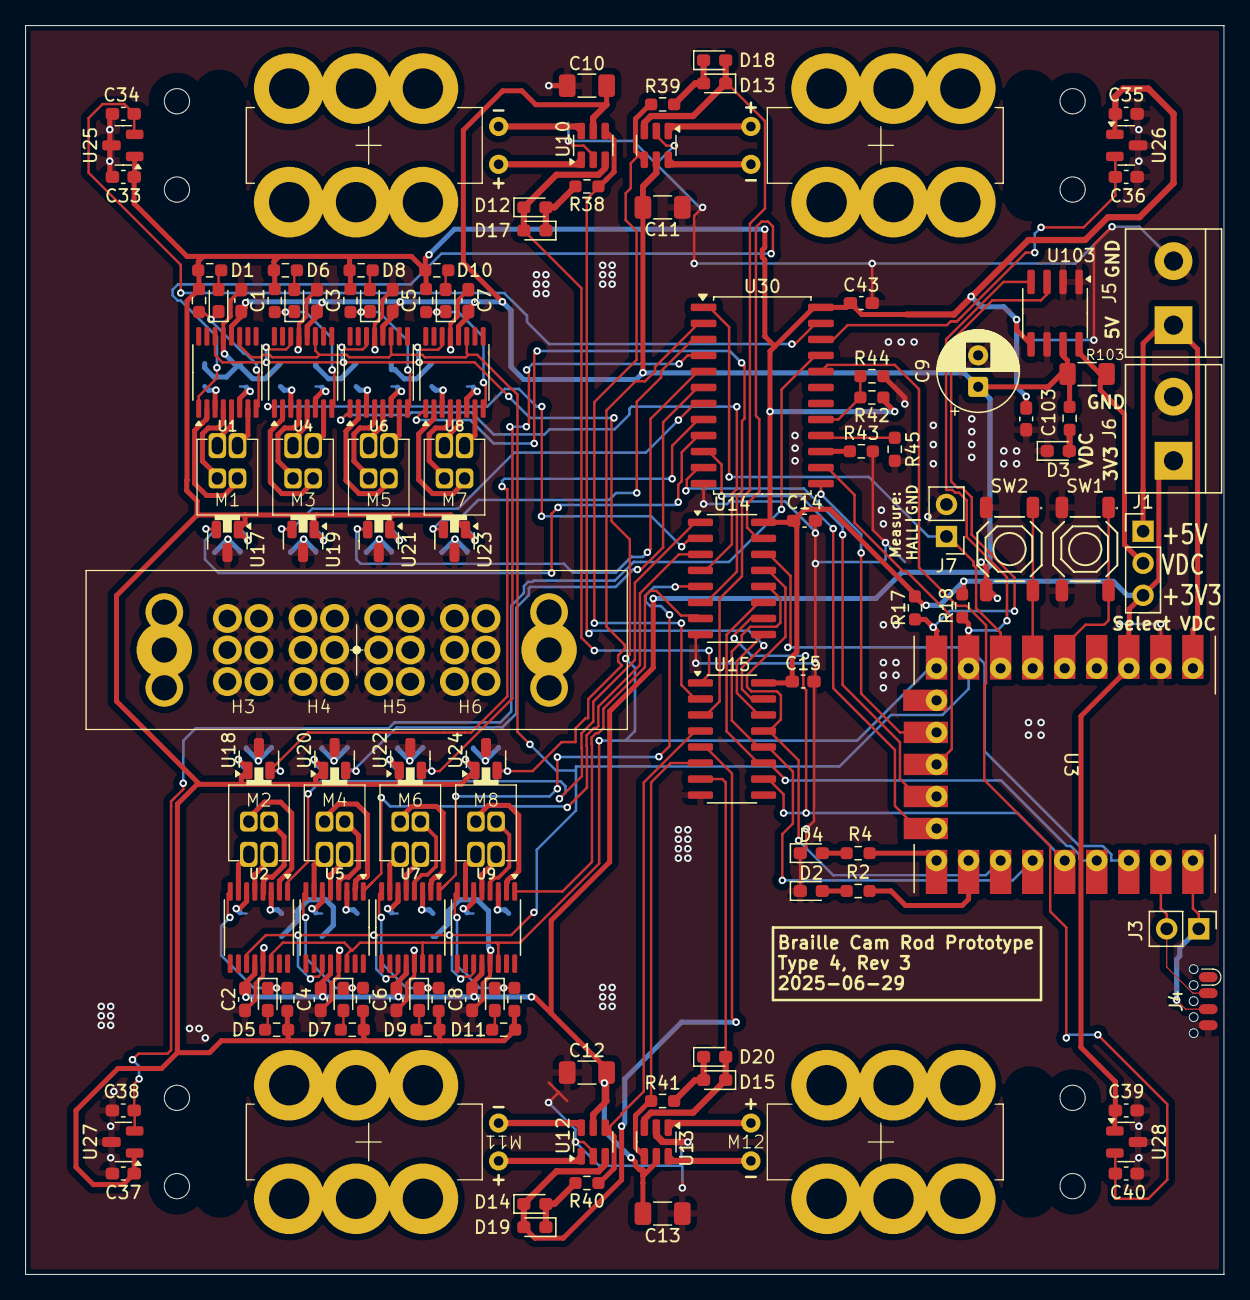
[picture p18: board Braille-Column-Rods-PCB.kicad_pcb from above]

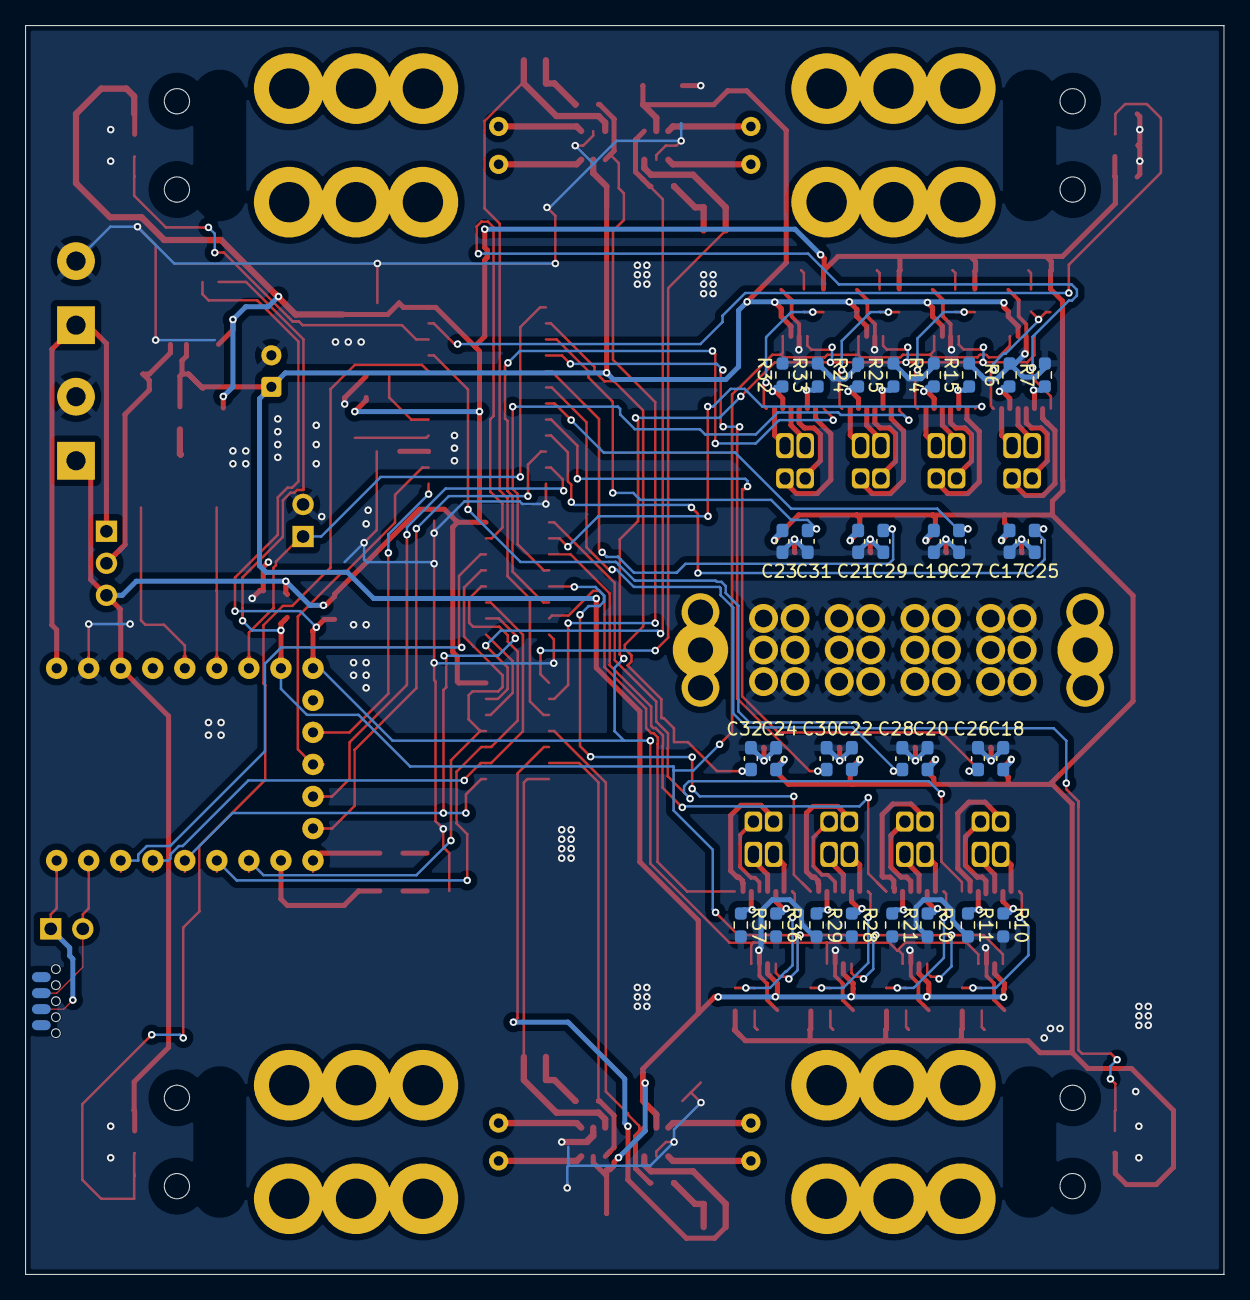
[picture p19: board Braille-Column-Rods-PCB.kicad_pcb from below]

Board: 2 copper layers, 95.0 x 99.0 mm, 161 parts (32 on the bottom side), 134 nets.
