KilowattSynthesis/Braille-Display-Column-Rods/(commit log)

2025-02-03 Add Type 4 Rev 1 PCB design
    [Braille-Column-Rods-PCB.kicad_pcb, Braille-Column-Rods-PCB.kicad_sch, Braille_Cell_Column.kicad_sch, Corner_DC_Motor.kicad_sch, Mechanical_Holes.kicad_sch, Microcontroller.kicad_sch, Motor_Control.kicad_sch, assembly_cam_and_dc_motor.step]
2025-02-03 Migrate cad and firmware (#1)
2025-02-03 Fix dimension issues with stepper motor
    [Braille-Column-Rods-PCB.kicad_pcb, Braille_Cell_Column.kicad_sch, Corner_DC_Motor.kicad_sch, Microcontroller.kicad_sch, Motor_Control.kicad_sch, micro_stepper_motor_od_4p7.step]
2025-02-03 More rounting
    [Braille-Column-Rods-PCB.kicad_pcb]
2025-02-03 Finish routing
    [Braille-Column-Rods-PCB.kicad_pcb, assembly_cam_and_dc_motor.step]
2025-02-03 cad: Add missing dc motor clamp
2025-02-03 cad: Add screw heads to dc motor clamp
2025-02-03 cad: Make thread-forming hole tighter on bushing block
2025-02-03 cad: Add x-limiter to DC motor clamp
2025-02-03 Polish prep for Rev 2 release, PCBA work
    [Braille-Column-Rods-PCB.kicad_pcb, Braille-Column-Rods-PCB.kicad_sch, Braille_Cell_Column.kicad_sch, Corner_DC_Motor.kicad_sch, Mechanical_Holes.kicad_sch, Microcontroller.kicad_sch, Motor_Control.kicad_sch]
2025-02-03 cad: improve clamping with space for wires
2025-02-03 Rename the housing assembly cad
2025-02-03 cad: Tweak print-in-place assembly properties, ordered
2025-02-03 cad: Add M2 mounting pegs for easy alignment
2025-02-03 Add scale notes to PCB for validating on paper
    [Braille-Column-Rods-PCB.kicad_pcb]
2025-02-21 fw: add hall self-test, LED checks
2025-02-21 fw: add stepper motor control
2025-02-21 cad(dc_motor_clamp): Change to thread-forming M3 screws on the corner holes
2025-02-22 cad(dc_motor_clamp): shift the motor toward its wires
    [Braille-Column-Rods-PCB.kicad_pcb, bushing_block.step, dc_motor_clamp.step]
2025-02-22 WIP: Create not-print-in-place housing
2025-02-24 WIP: Switch to new style of insertable rods
2025-02-24 Add printable assembly
2025-03-13 cad: Add order variants comment
2025-03-13 pcb: Add new renders
    [Braille-Column-Rods-PCB.kicad_pcb, octagon_cam_housing_assembly_preview_3p2_coupler.step, octagon_cam_housing_assembly_preview_3p9_coupler.step]
2025-03-27 cad: Increase motor shaft size
2025-03-27 cad: Decrease material usage
2025-06-30 chore: bump to KiCAD v8 on re-save
    [Braille-Column-Rods-PCB.kicad_pcb, Braille-Column-Rods-PCB.kicad_sch, Braille_Cell_Column.kicad_sch, Corner_DC_Motor.kicad_sch, Mechanical_Holes.kicad_sch, Microcontroller.kicad_sch, Motor_Control.kicad_sch]
2025-06-30 feat: add INA219 current sensor
    [Braille-Column-Rods-PCB.kicad_pcb, Braille-Column-Rods-PCB.kicad_sch, Braille_Cell_Column.kicad_sch, Motor_Control.kicad_sch]
2025-06-30 fix(pcb,layout): move capacitors farther from DC motor drivers
    [Braille-Column-Rods-PCB.kicad_pcb]
2025-06-30 Bump version, update motor footprint precision
    [Braille-Column-Rods-PCB.kicad_pcb, Braille-Column-Rods-PCB.kicad_sch, Braille_Cell_Column.kicad_sch, Corner_DC_Motor.kicad_sch, Mechanical_Holes.kicad_sch, Microcontroller.kicad_sch, Motor_Control.kicad_sch]
2025-06-30 Shink housing mounting holes from 2.2mm to 2.0mm
    [Braille-Column-Rods-PCB.kicad_pcb]
2025-06-30 Add PTHs under dots for each cell
    [Braille-Column-Rods-PCB.kicad_pcb, Mechanical_Holes.kicad_sch]
2025-06-30 Update PCB renders
2025-08-13 cad: add assembly_jig part
2025-08-14 cad: update assembly_jig dimensions
2025-08-25 cad(enclosure): add overall preview of all parts
2025-08-25 cad(enclosure): update methodology, sync layout variables
2025-08-26 cad(enclosure): remove rp2040 cutout
2025-08-26 cad(enclosure): add bottom standoffs, cam interfaces, spring posts
2025-08-26 cad(enclosure): update TODO - spring size
2025-08-26 cad(enclosure): add top stopper near springs
2025-08-27 cad(enclosure): fix bottom enclosure errata (v2)
    * standoffs were in the way
    * cam interface too short
    [column_rod_enclosure.py]
2025-08-28 cad(enclosure): improve render, move springs
2025-08-28 cad(enclosure): add retention wall, viewing port
2025-08-28 cad(enclosure): add top-down cam interfaces
2025-08-30 fw: add corner motor zeroing sequence
2025-08-30 cad(housing): decrease hole size and top face thickness [order]
2025-08-30 cad(raiser_cam): change magnet OD from 2.0 to 2.1
2025-08-30 cad(motor_clamp): use pegs and thread-forming screws
2025-08-30 other_pcb(Dot-Alignment-PCB): create Dot-Alignment-PCB for order
    [Dot-Alignment-PCB.kicad_pcb, Dot-Alignment-PCB.kicad_sch]
2025-08-30 cad: fix bad import path
    [column_rod_housing_assembly_print_in_place.py]
2025-08-30 cad(dot_retainer): add dot retainer cad
